Teketa/COS-102-ESP32-S31-Function-CoreBoard-1-Hat/jlcpcb_bom.csv

Comment | Designator | Footprint | LCSC | Assembly
100nF | C1,C2,C3,C5,C7,C9 | C_0603_1608Metric | C14663 | SMT
10uF | C4 | C_0805_2012Metric | C15850 | SMT
1000uF 16V | C6 | CP_Radial_D10.0mm_P5.00mm | C110138 | THT (hand solder)
470uF 10V | C8 | CP_Radial_D8.0mm_P3.50mm | C1579341 | THT (hand solder)
SMBJ5.0A | D1 | D_SMB | C113974 | SMT
SS34 | D2 | D_SMA | C8678 | SMT
2A slow | F1 | Fuse_Littelfuse-NANO2-451_453 | C142852 | SMT
120R@100MHz 3A | FB1,FB2 | L_1206_3216Metric | C85841 | SMT
220R@100MHz | FB3 | L_0603_1608Metric | C80165 | SMT
PSU 5V IN | J1 | TerminalBlock_Phoenix_MKDS-1,5-2-5.08_1x02_P5.08mm_Horizontal | C7509570 | THT (hand solder)
CoreBoard1_J2 | J2 | PinSocket_2x20_P2.54mm_Vertical | C132132 | THT (hand solder)
47uH | L1 | L_Bourns_SRR1260 | C1329363 | SMT
COS-102 IN | P1 | IDC-Header_2x08_P2.54mm_Vertical | C492443 | THT (hand solder)
33 | R1,R2,R3,R4,R5,R6,R7,R8,R9,R10 | R_0603_1608Metric | C23140 | SMT
SN74AHCT125DR | U8,U9,U10 | SOIC-14_3.9x8.7mm_P1.27mm | C155176 | SMT
