Teketa/COS-102-ESP32-S31-Function-CoreBoard-1-Hat/cos102_s31_hat.kicad_pcb

## KiCad design cos102_s31_hat.kicad_pcb (2026-11-05)

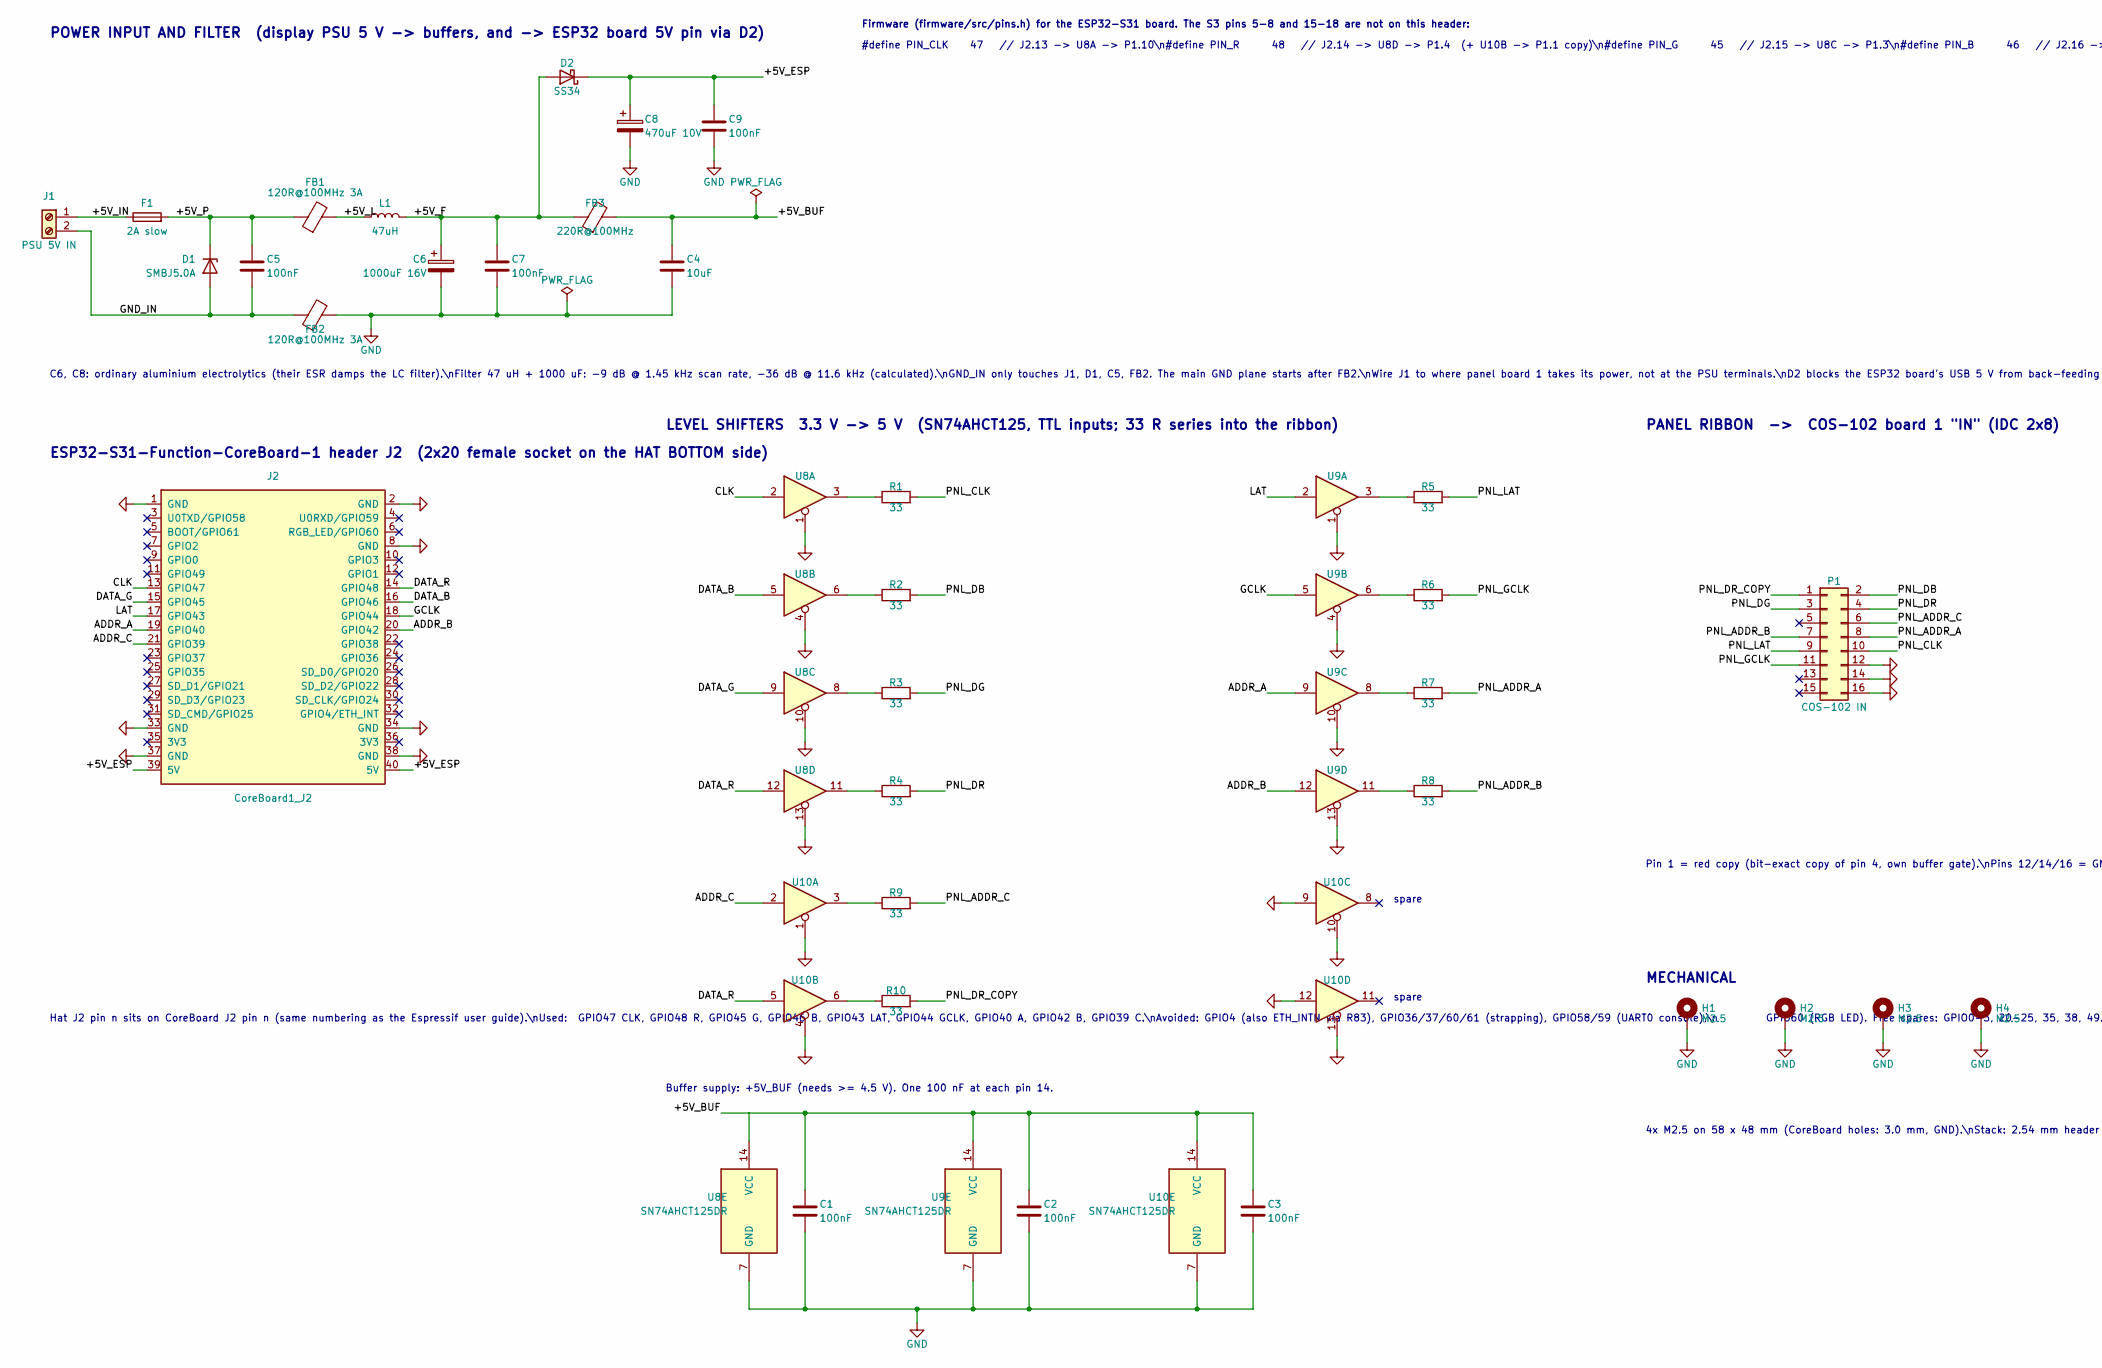
[picture p1: schematic cos102_s31_hat.kicad_sch, COS-102 LED sign hat for ESP32-S31-Function-CoreBoard-1, part in row 1, column 1]

Parts:
C1, C2, C3, C7, C9: 100nF; C_0603_1608Metric; MPN YAGEO CC0603KRX7R9BB104 (100nF 50V X7R); LCSC C14663
C4: 10uF; C_0805_2012Metric; Voltage 10V X5R; MPN Samsung CL21A106KAYNNNE (10uF 25V X5R); LCSC C15850
C5: 100nF; C_0603_1608Metric; Voltage 16V X7R; MPN YAGEO CC0603KRX7R9BB104 (100nF 50V X7R); LCSC C14663
C6: 1000uF 16V; CP_Radial_D10.0mm_P5.00mm; MPN Rubycon 16YXF1000MEFC10X20 (1000uF 16V,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; LCSC C110138
C8: 470uF 10V; CP_Radial_D8.0mm_P3.50mm; MPN Nichicon UHE1A471MPD1TD (470uF 10V, 8 m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; LCSC C1579341
D1: SMBJ5.0A; D_SMB; MPN MDD SMBJ5.0A (unidirectional TVS, SMB); LCSC C113974
D2: SS34; D_SMA; MPN MDD SS34 (3 A 40 V Schottky, SMA); LCSC C8678
F1: 2A slow; Fuse_Littelfuse-NANO2-451_453; MPN Littelfuse 0452002.MRL (2 A slow-blow, 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; LCSC C142852
FB1, FB2: 120R@100MHz 3A; L_1206_3216Metric; MPN Murata BLM31PG121SN1L (120R@100MHz, 3.5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; LCSC C85841
FB3: 220R@100MHz; L_0603_1608Metric; MPN Murata BLM18PG221SN1D (220R@100MHz, 1.4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; LCSC C80165
H1, H2, H3, H4: M2.5; MountingHole_2.7mm_M2.5_Pad_Via
J1: PSU 5V IN; TerminalBlock_Phoenix_MKDS-1,5-2-5.08_1x02_P5.08mm_Horizont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; MPN Phoenix Contact 1729128 (MKDS 1,5/2-5,0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; LCSC C7509570
J2: CoreBoard1_J2; PinSocket_2x20_P2.54mm_Vertical; MPN CONNFLY DS1023-2*20SF11 (2x20 female 2.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; LCSC C132132
L1: 47uH; L_Bourns_SRR1260; MPN Bourns SRR1260-470M (47uH, Isat 2.6 A, 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; LCSC C1329363
P1: COS-102 IN; IDC-Header_2x08_P2.54mm_Vertical; MPN XFCN BH254V-16P (2x8 box header 2.54 mm); LCSC C492443
R1, R2, R3, R4, R5, R6, R7, R8, R9, R10: 33; R_0603_1608Metric; MPN UNI-ROYAL 0603WAF330JT5E (33R 1%); LCSC C23140
U8, U9, U10: SN74AHCT125DR; SOIC-14_3.9x8.7mm_P1.27mm; MPN TI SN74AHCT125DR; LCSC C155176

Connections:
+5V_BUF: C1.1, C2.1, C3.1, C4.1, FB3.2, U8.14 (VCC), U9.14 (VCC), U10.14 (VCC)
+5V_ESP: C8.1, C9.1, D2.1 (K), J2.39 (5V), J2.40 (5V)
+5V_F: C6.1, C7.1, D2.2 (A), FB3.1, L1.2
+5V_IN: F1.1, J1.1
+5V_L: FB1.2, L1.1
+5V_P: C5.1, D1.1 (K), F1.2, FB1.1
ADDR_A: J2.19 (GPIO40), U9.9
ADDR_B: J2.20 (GPIO42), U9.12
ADDR_C: J2.21 (GPIO39), U10.2
CLK: J2.13 (GPIO47), U8.2
DATA_B: J2.16 (GPIO46), U8.5
DATA_G: J2.15 (GPIO45), U8.9
DATA_R: J2.14 (GPIO48), U8.12, U10.5
GCLK: J2.18 (GPIO44), U9.5
GND: C1.2, C2.2, C3.2, C4.2, C6.2, C7.2, C8.2, C9.2, FB2.2, H1.1, H2.1, H3.1, H4.1, J2.1 (GND), J2.2 (GND), J2.8 (GND), J2.33 (GND), J2.34 (GND), J2.37 (GND), J2.38 (GND), P1.12, P1.14, P1.16, U8.1, U8.4, U8.7 (GND), U8.10, U8.13, U9.1, U9.4, U9.7 (GND), U9.10, U9.13, U10.1, U10.4, U10.7 (GND), U10.9, U10.10, U10.12, U10.13
GND_IN: C5.2, D1.2 (A), FB2.1, J1.2
LAT: J2.17 (GPIO43), U9.2
unnamed: R1.1, U8.3
unnamed: R2.1, U8.6
unnamed: R3.1, U8.8
unnamed: R4.1, U8.11
unnamed: R5.1, U9.3
unnamed: R6.1, U9.6
unnamed: R7.1, U9.8
unnamed: R8.1, U9.11
unnamed: R9.1, U10.3
unnamed: R10.1, U10.6
PNL_ADDR_A: P1.8, R7.2
PNL_ADDR_B: P1.7, R8.2
PNL_ADDR_C: P1.6, R9.2
PNL_CLK: P1.10, R1.2
PNL_DB: P1.2, R2.2
PNL_DG: P1.3, R3.2
PNL_DR: P1.4, R4.2
PNL_DR_COPY: P1.1, R10.2
PNL_GCLK: P1.11, R6.2
PNL_LAT: P1.9, R5.2

Notes on the sheet:
POWER INPUT AND FILTER (display PSU 5 V -> buffers, and -> ESP32 board 5V pin via D2)
C6, C8: ordinary aluminium electrolytics (their ESR damps the LC filter).\nFilter 47 uH + 1000 uF: -9 dB @ 1.45 kHz scan rate, -36 dB @ 11.6 kHz (calculated).\nGND_IN only touches J1, D1, C5, FB2. The main GND plane starts after FB2.\nWire J1 to where panel board 1 takes its power, not at the PSU t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
ESP32-S31-Function-CoreBoard-1 header J2 (2x20 female socket on the HAT BOTTOM side)
Hat J2 pin n sits on CoreBoard J2 pin n (same numbering as the Espressif user guide).\nUsed: GPIO47 CLK, GPIO48 R, GPIO45 G, GPIO46 B, GPIO43 LAT, GPIO44 GCLK, GPIO40 A, GPIO42 B, GPIO39 C.\nAvoided: GPIO4 (also ETH_INTN via R83), GPIO36/37/60/61 (strapping), GPIO58/59 (UART0 console),\n GPIO60 (RG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
LEVEL SHIFTERS 3.3 V -> 5 V (SN74AHCT125, TTL inputs; 33 R series into the ribbon)
spare
Buffer supply: +5V_BUF (needs >= 4.5 V). One 100 nF at each pin 14.
PANEL RIBBON -> COS-102 board 1 "IN" (IDC 2x8)
Pin 1 = red copy (bit-exact copy of pin 4, own buffer gate).\nPins 12/14/16 = GND (measured).\nPins 5/13/15 unknown: NOT connected until metered.\nPanel inputs: 5 V HC logic (SN74HC244 buffers).\nStable to ~19.5 MHz; 18 MHz recommended.
MECHANICAL
4x M2.5 on 58 x 48 mm (CoreBoard holes: 3.0 mm, GND).\nStack: 2.54 mm header plastic + 8.5 mm socket = 11 mm.\nUse M2.5 x 11 mm standoffs.\nCut-out over the RJ45 and side-mount USB-A (13+ mm tall).\n3.2 mm holes give access to BOOT and RST.\nNo copper over the module antenna (left edge).
Firmware (firmware/src/pins.h) for the ESP32-S31 board. The S3 pins 5-8 and 15-18 are not on this header:
#define PIN_CLK 47 // J2.13 -> U8A -> P1.10\n#define PIN_R 48 // J2.14 -> U8D -> P1.4 (+ U10B -> P1.1 copy)\n#define PIN_G 45 // J2.15 -> U8C -> P1.3\n#define PIN_B 46 // J2.16 -> U8B -> P1.2\n#define PIN_LAT 43 // J2.17 -> U9A -> P1.9\n#define PIN_GCLK 44 // J2.18 -> U9B -> P1.11\n#define PIN_ADDR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

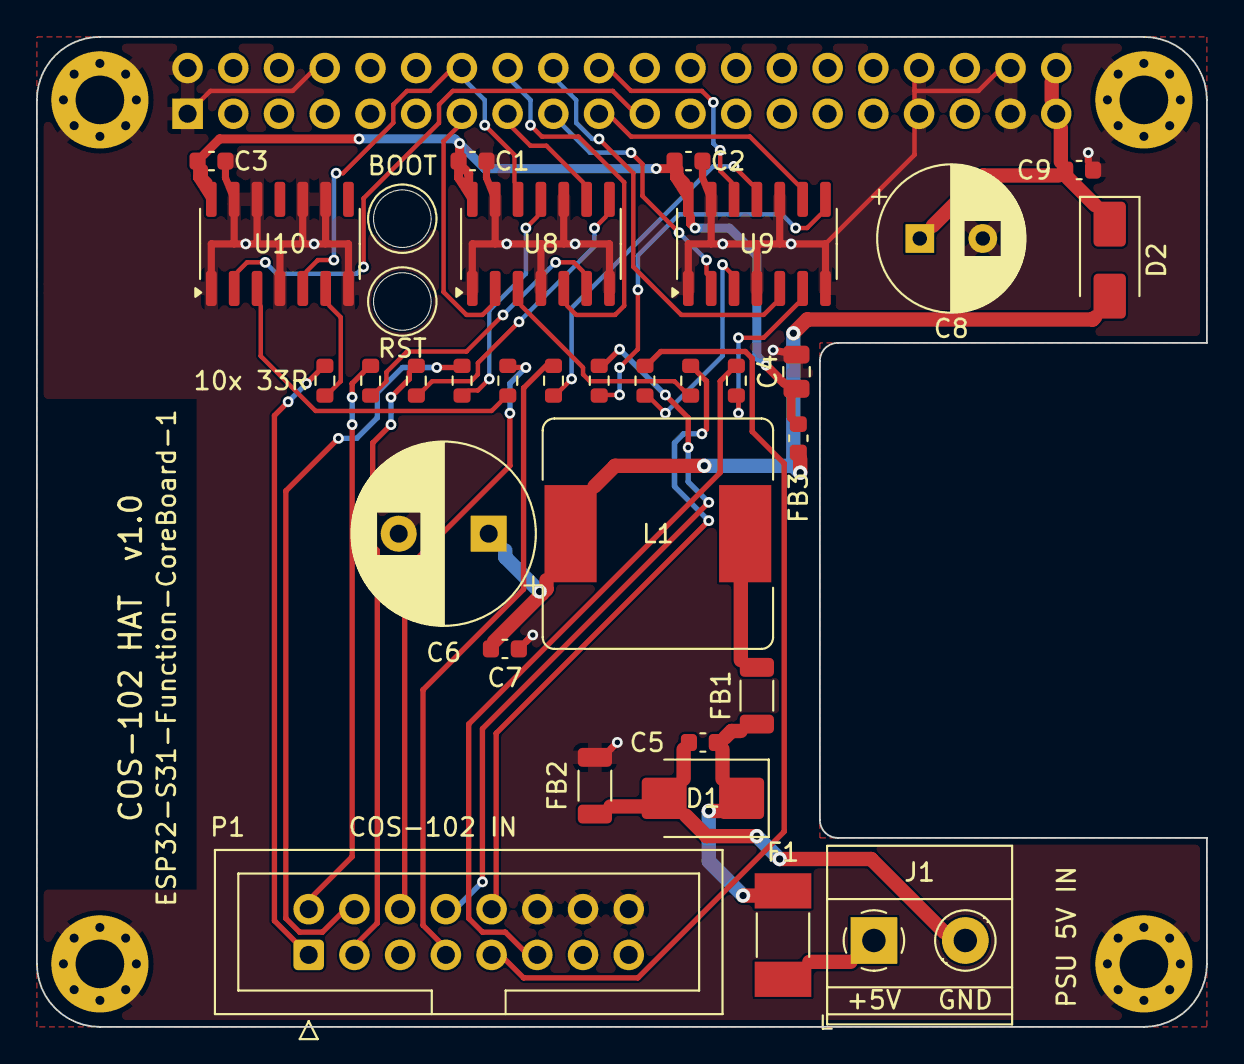
[picture p2: board cos102_s31_hat.kicad_pcb from above]

Board: 2 copper layers, 65.0 x 55.0 mm, 38 parts (1 on the bottom side), 37 nets.

Other parts of the board:
H5: BOOT access; AccessHole_3.2mm
H6: RST access; AccessHole_3.2mm
